skszaal/DBT2024/README.md

# DBT2024
This is the repository for the 2024 DBT project completed for MECE  2304
In this repostiory there is the arduino code, drawings/images of the project, and our final report.
