skszaal/DBT2024/Images_TechnicalDrawings/Caster wheel Drawing v1.pdf

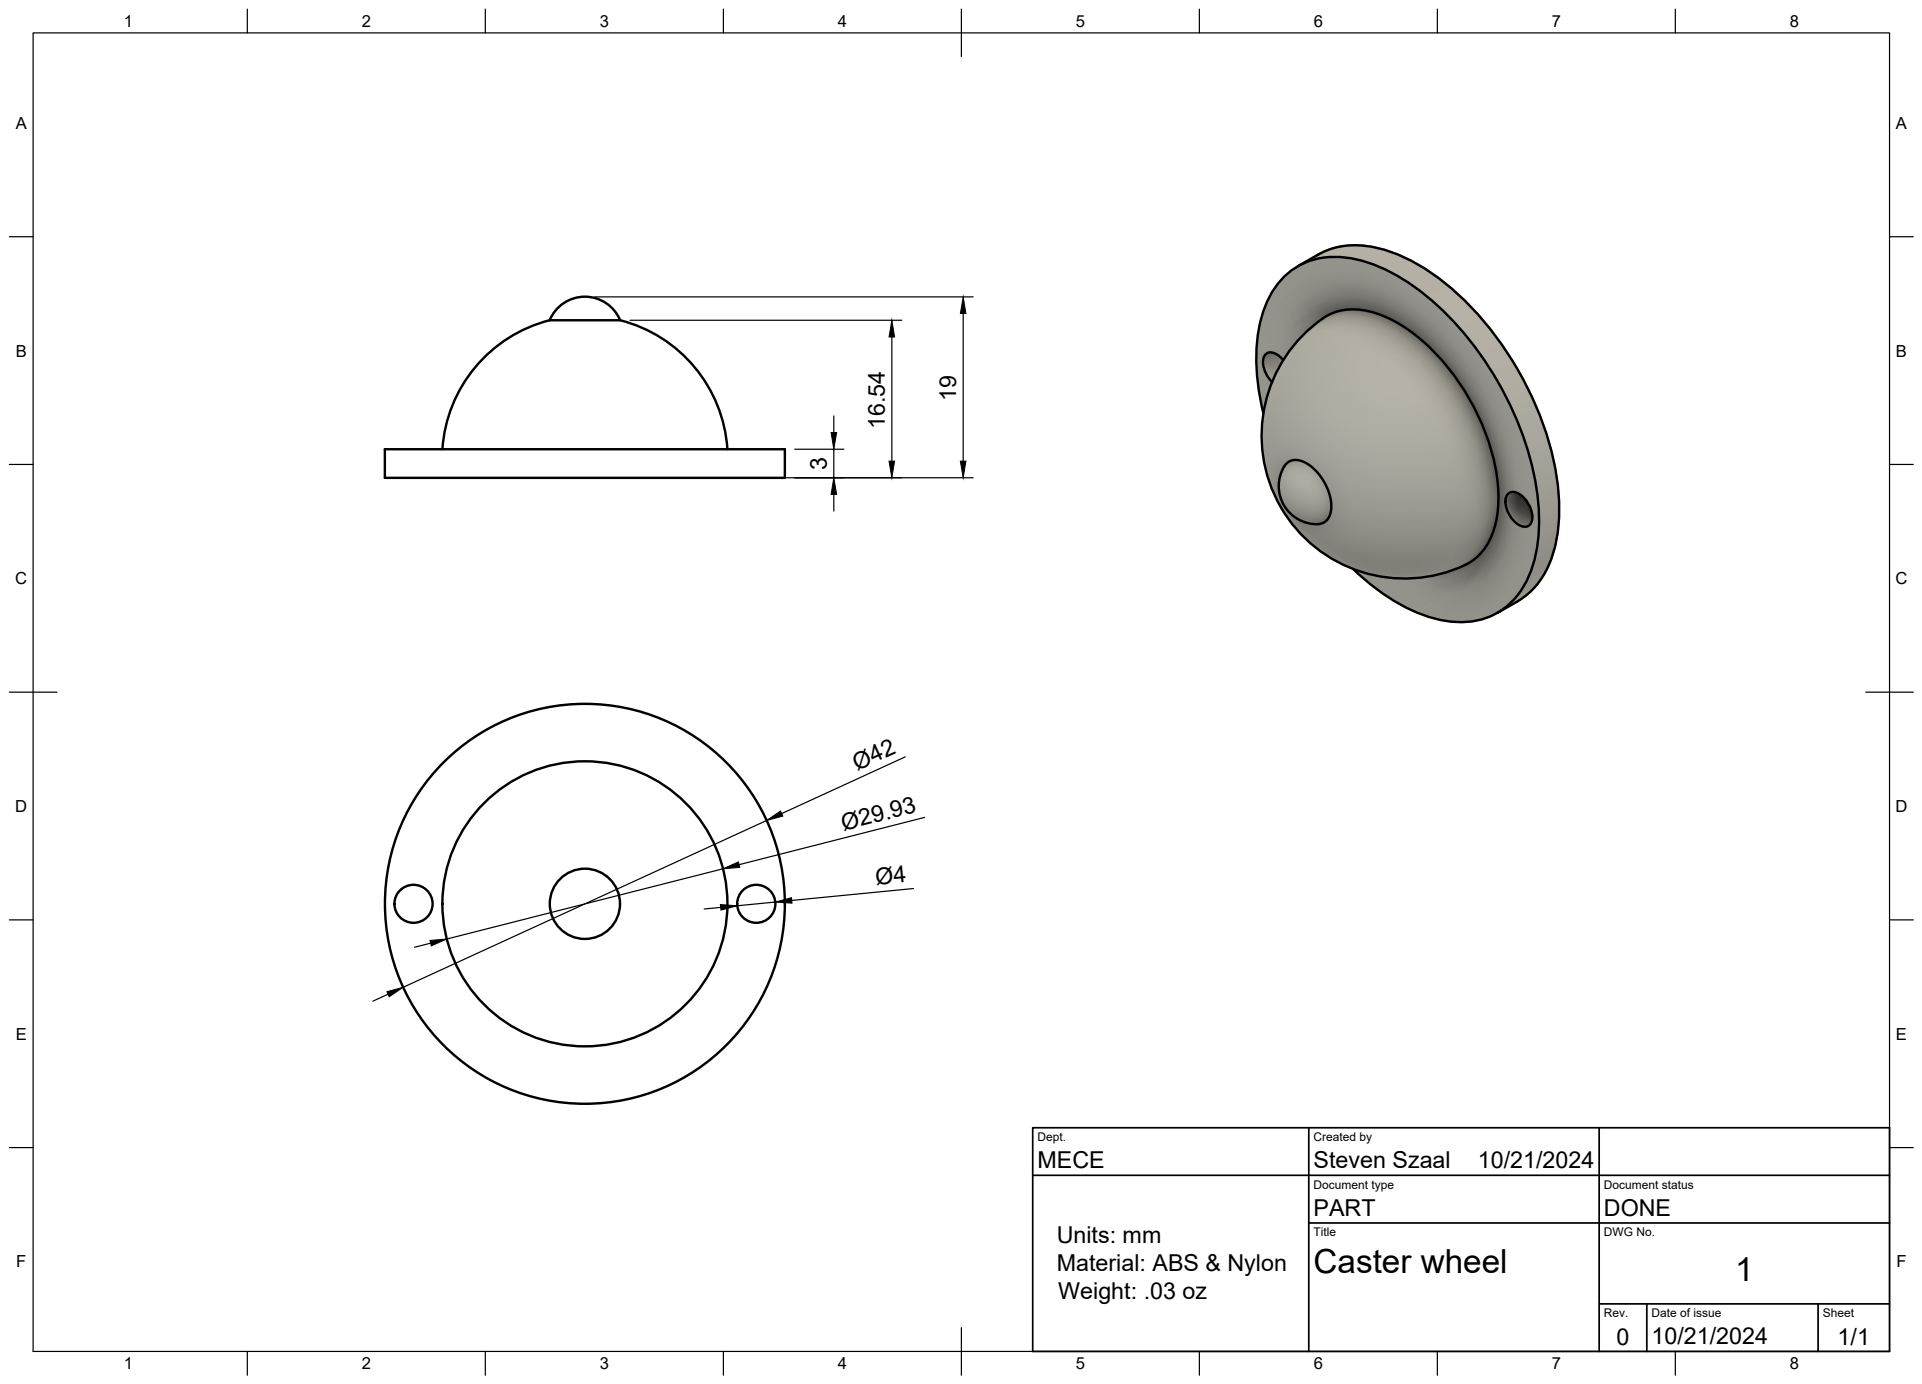
[picture p7: page 1]
Weight: .03 oz 19; Title; DWG No.; Rev.; Date of issue; Sheet; Caster wheel

Dept. MECE | Created by Steven Szaal 10/21/2024

Document type PART | Document status DONE

Units: mm
Material: ABS & Nylon
