skszaal/DBT2024/Images_TechnicalDrawings/Claw Arms.pdf

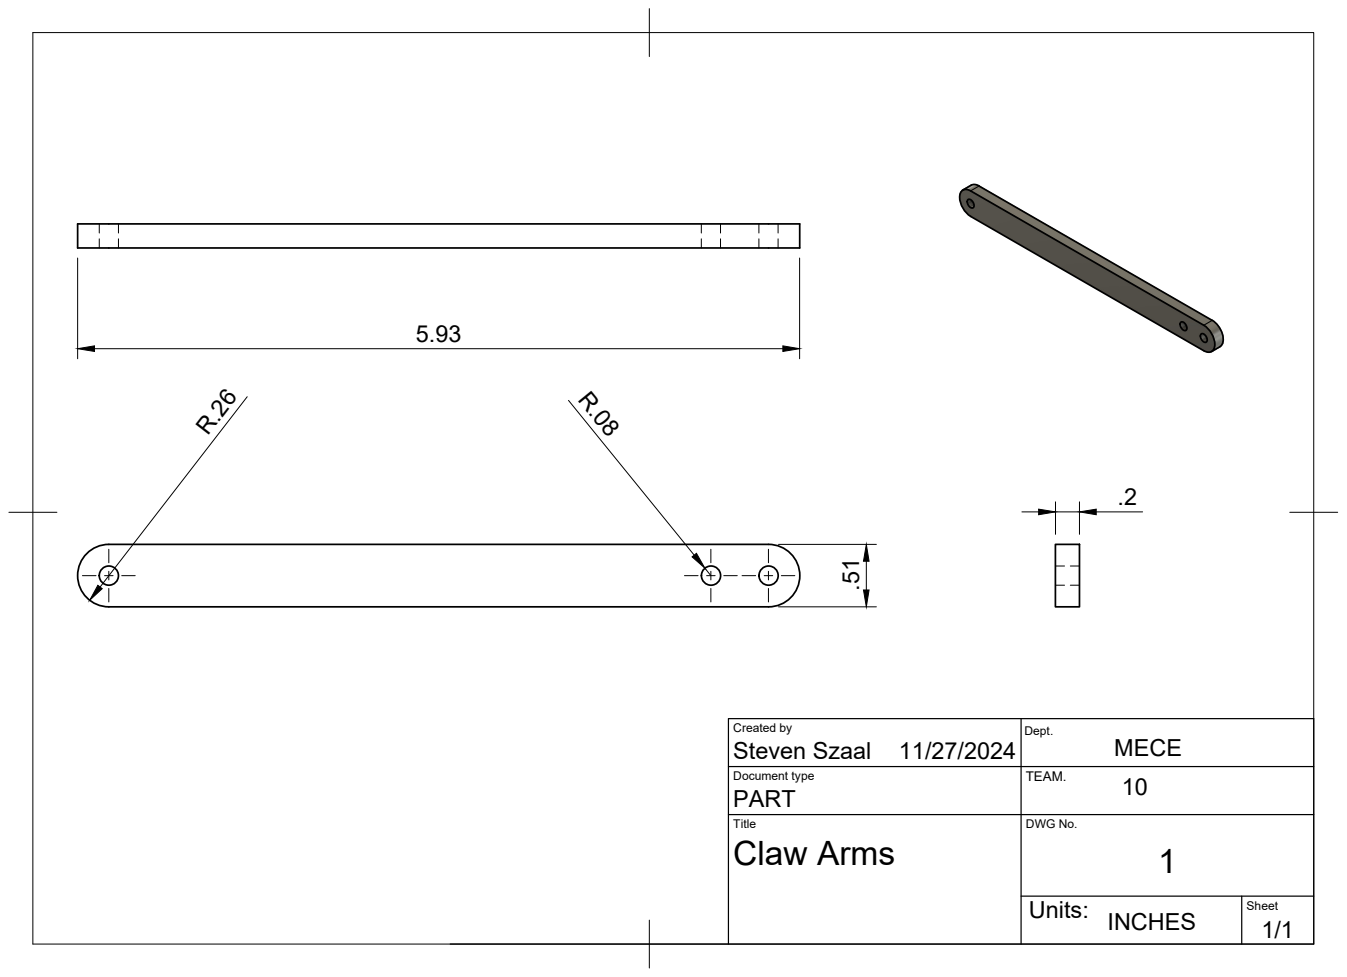
[picture p8: page 1]
Title; DWG No.; Claw Arms; INCHES .51

Created by Steven Szaal 11/27/2024 | Dept. MECE

Document type PART | TEAM. 10
