skszaal/DBT2024/Images_TechnicalDrawings/Motor brakets Drawing.pdf

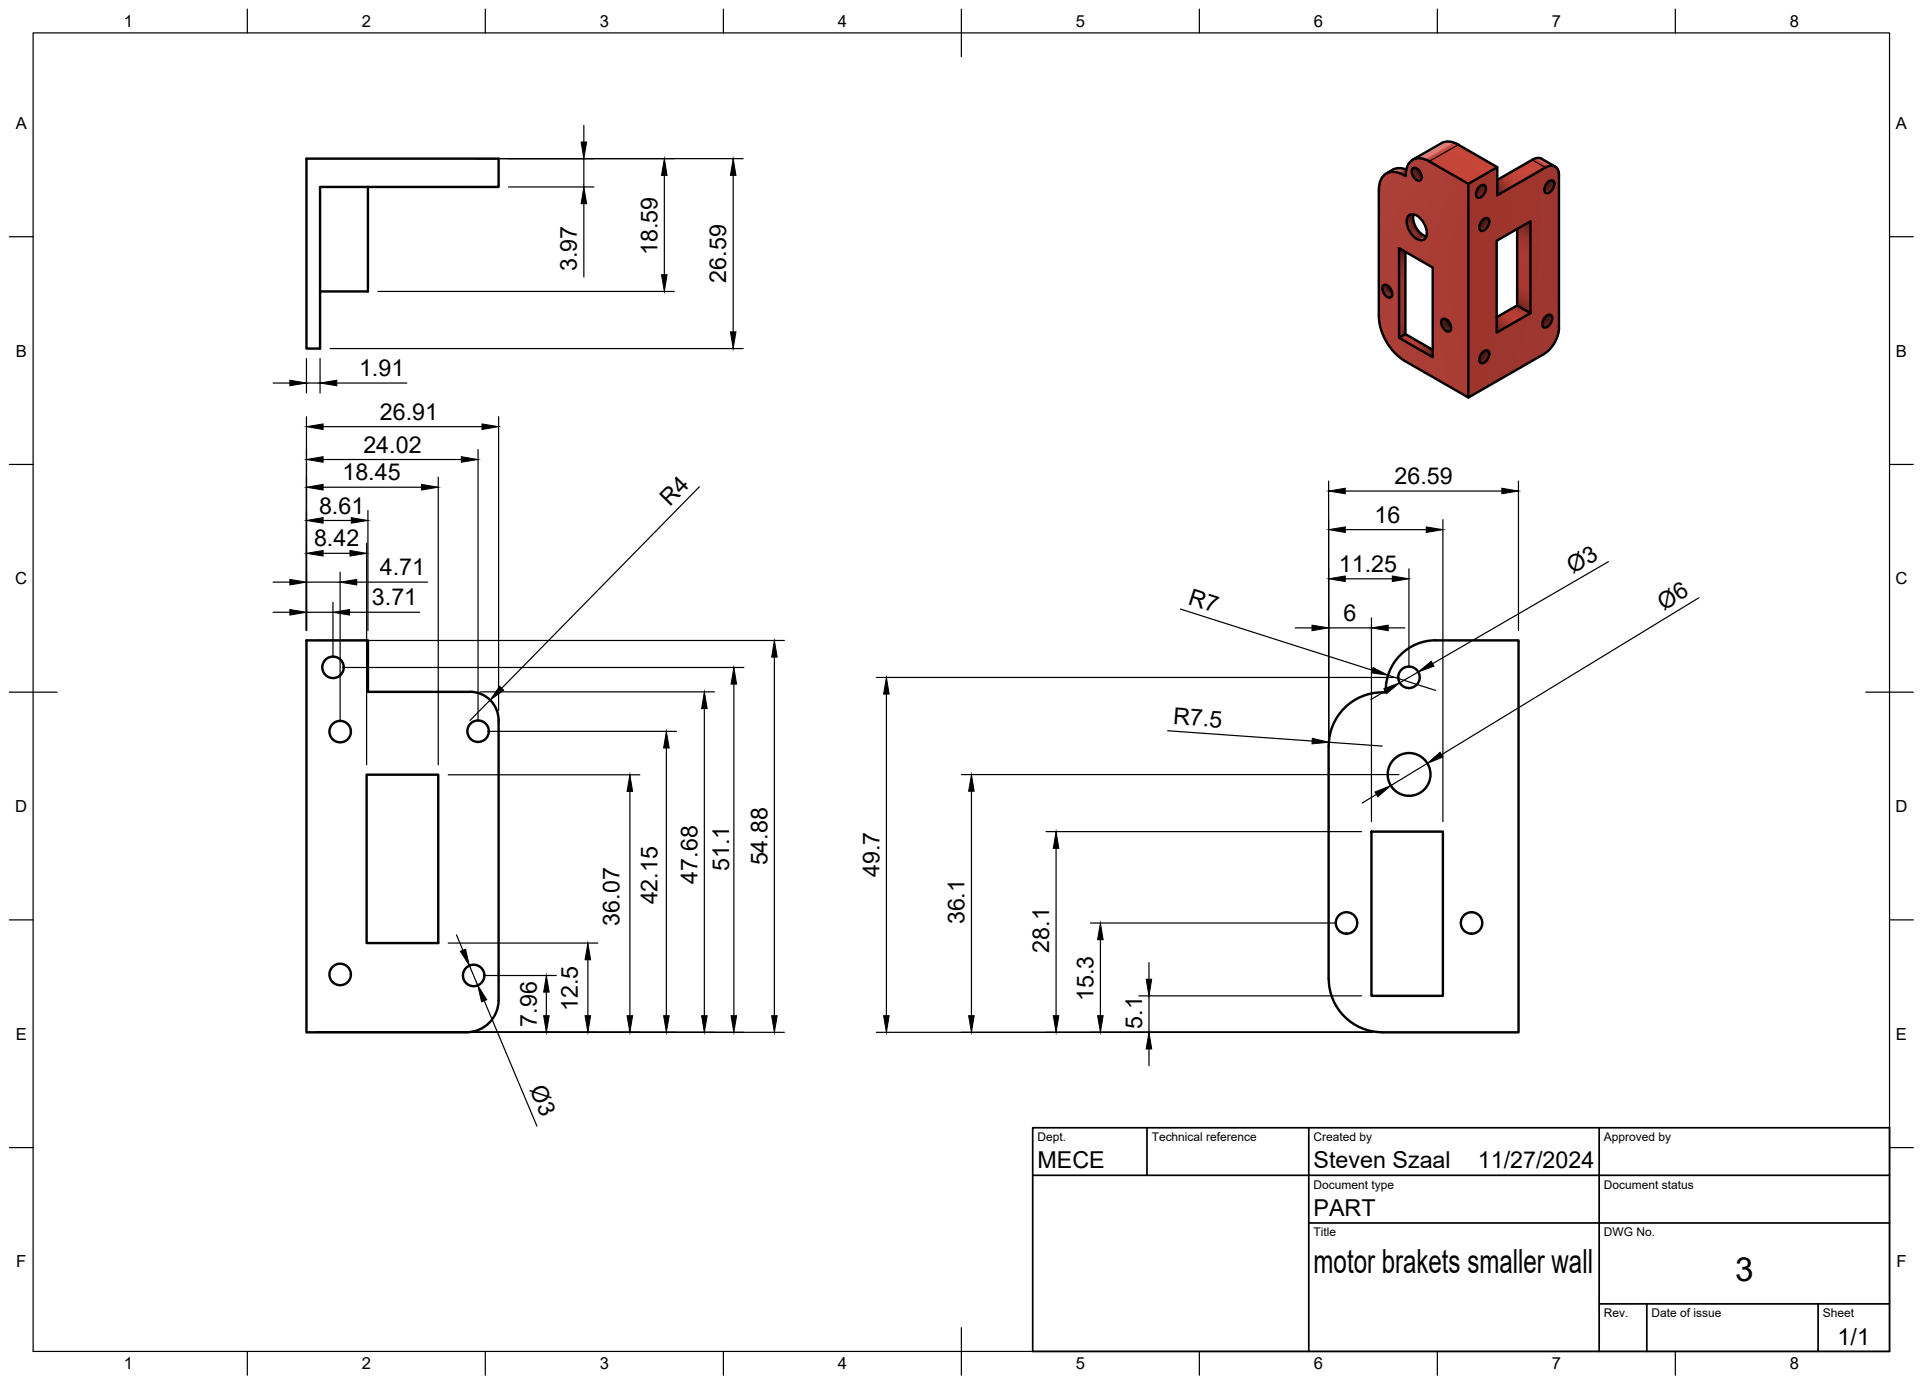
[picture p9: page 1]
8 BCDEF; ABCDEF; Title; DWG No.; Rev.; Date of issue; Sheet; motor brakets smaller wall; MECE; Steven Szaal 54.88 47.68 12.5

Dept. | Technical reference | Created by 11/27/2024 | Approved by

Document type PART | Document status
