skszaal/DBT2024/Images_TechnicalDrawings/Steppertowerweight Drawing v0.pdf

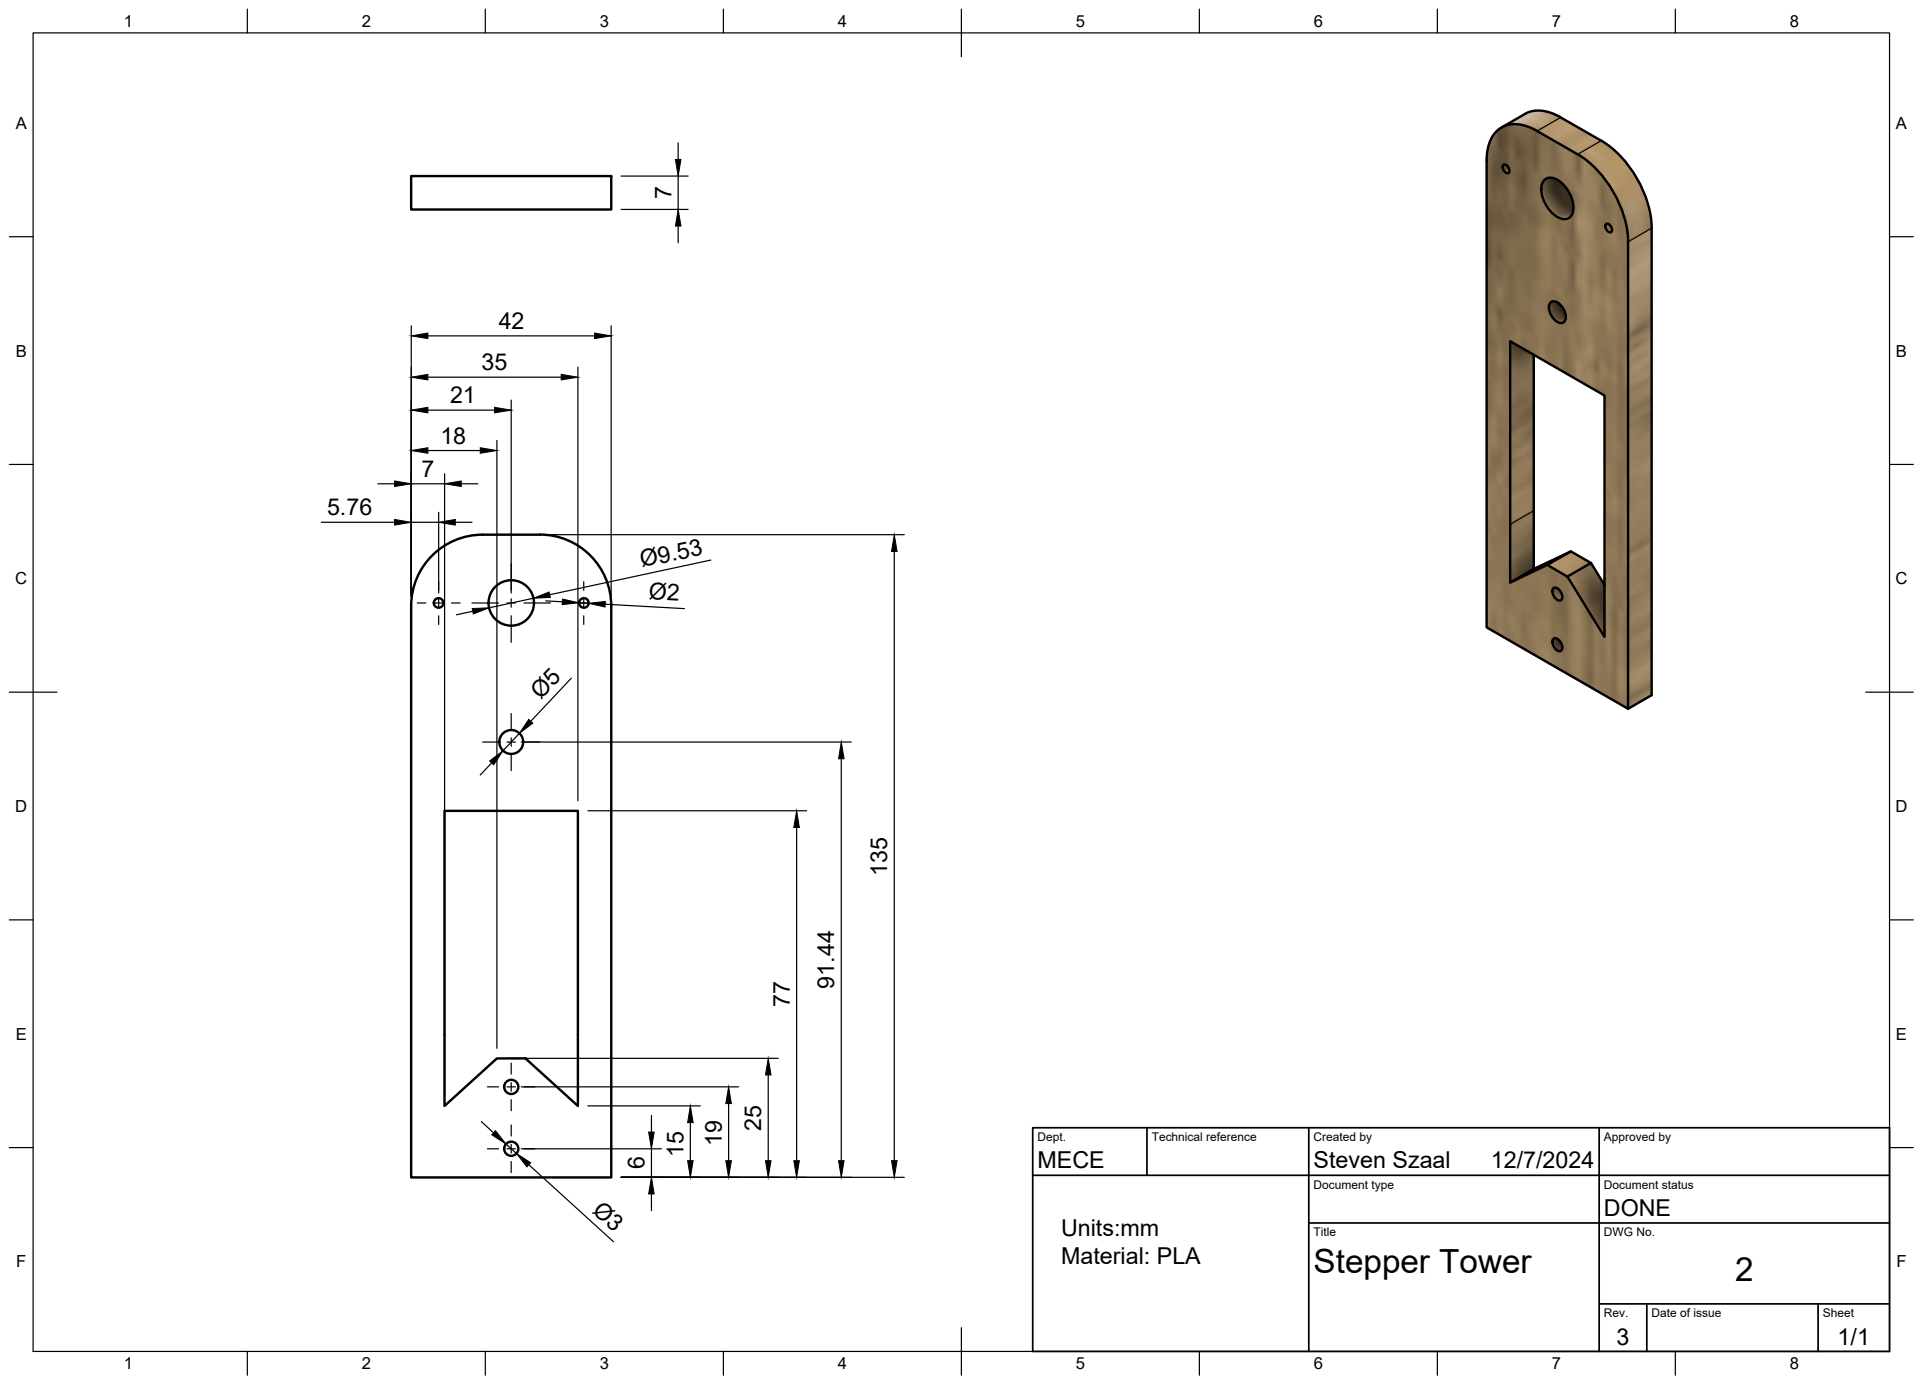
[picture p10: page 1]
Title; DWG No.; Rev.; Date of issue; Sheet; Stepper Tower; MECE; Steven Szaal 135; Material: PLA

Dept. | Technical reference | Created by 12/7/2024 | Approved by

Document type | Document status DONE
