skszaal/DBT2024/Images_TechnicalDrawings/Tower bracket Drawing v1.pdf

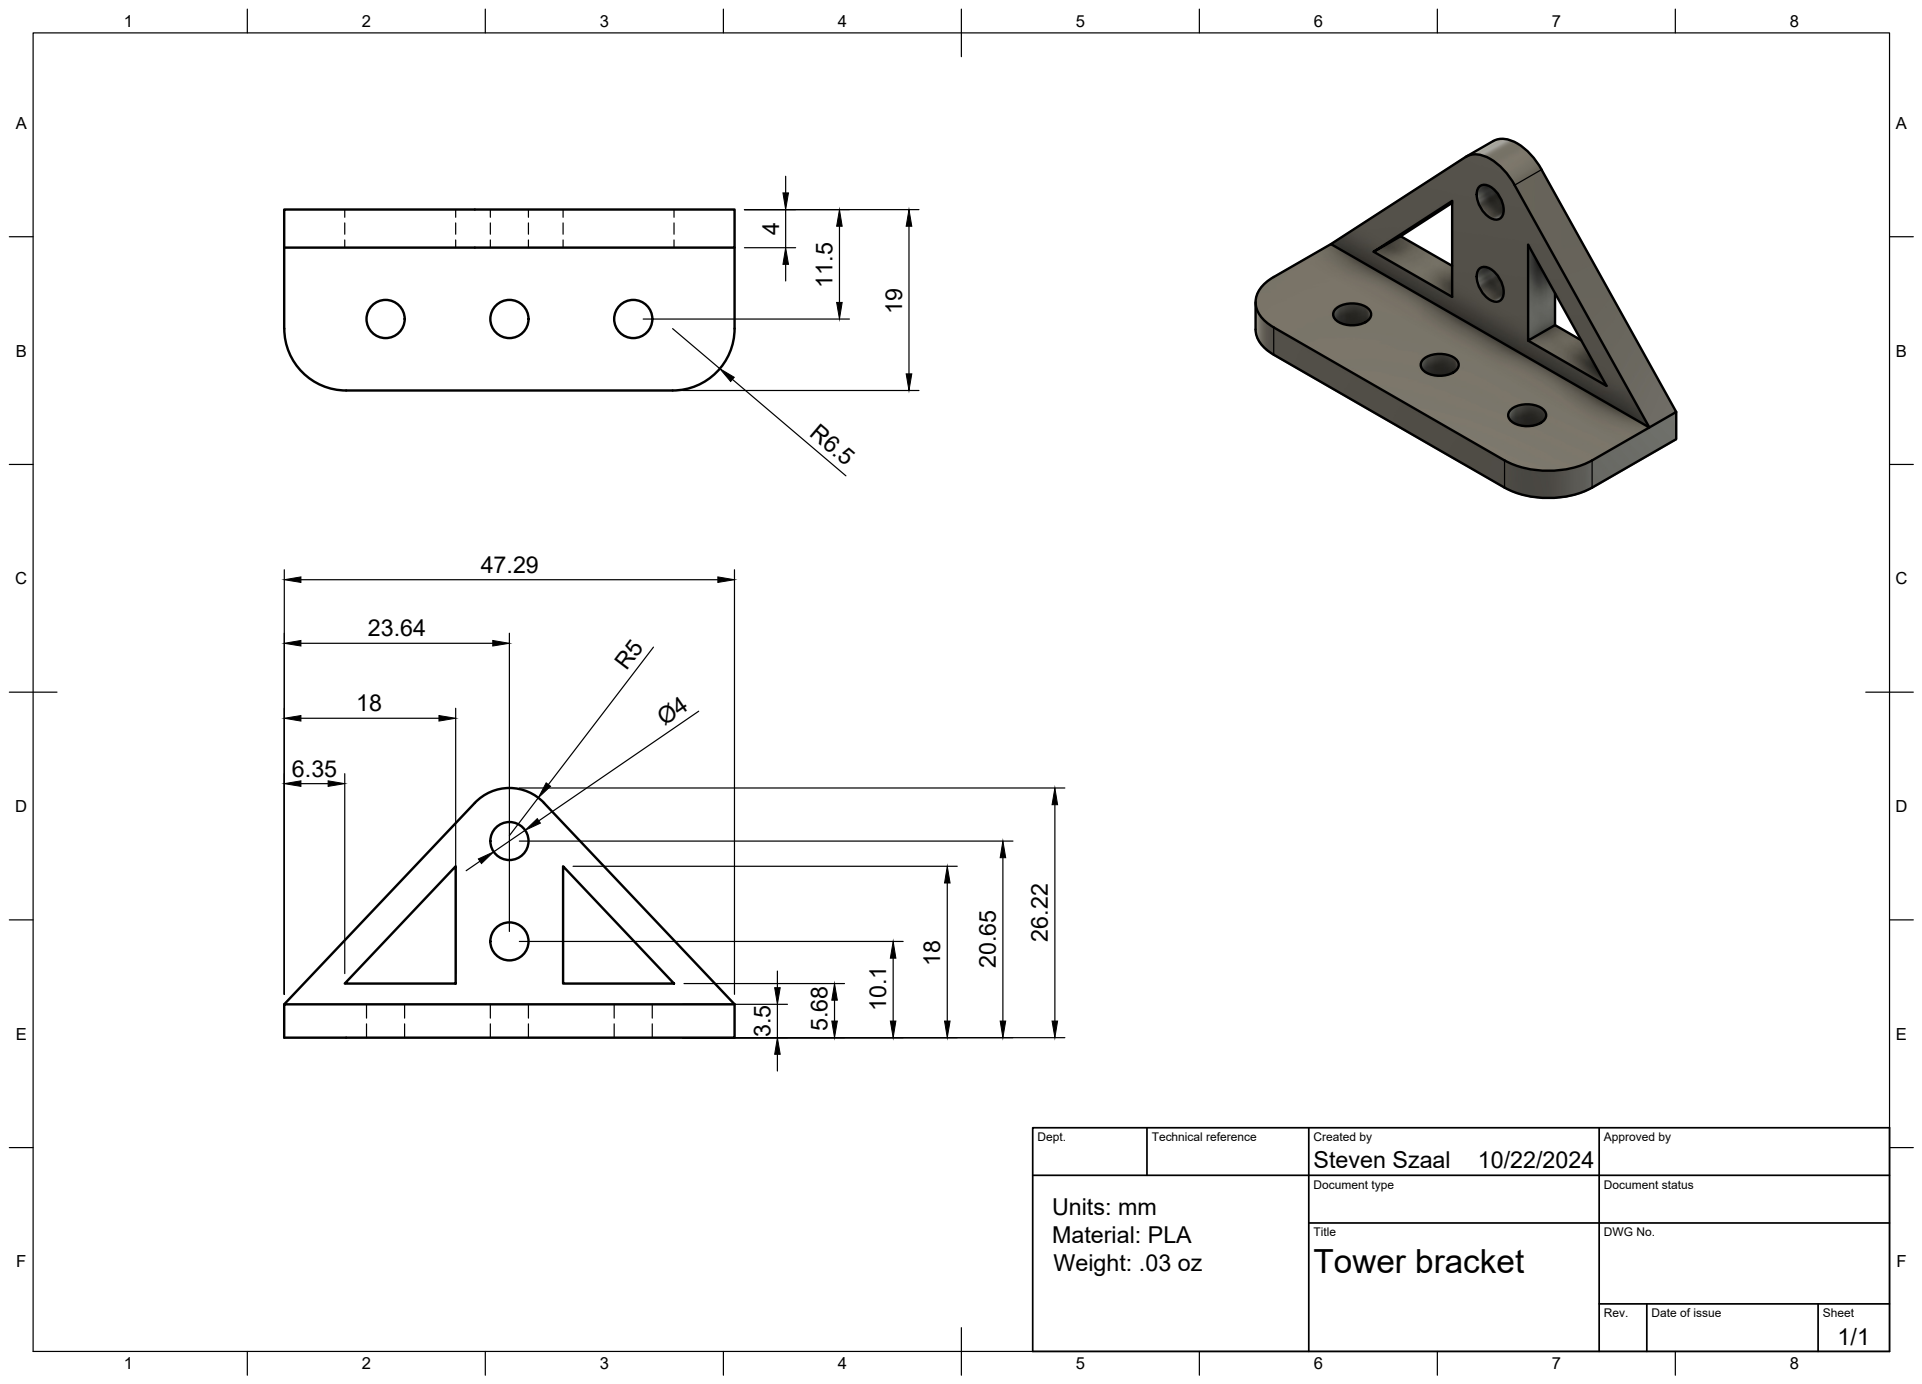
[picture p11: page 1]
Title; DWG No.; Rev.; Date of issue; Sheet; Tower bracket; Units: mm Material: PLA Weight: .03 oz

Dept. | Technical reference | Created by Steven Szaal 10/22/2024 | Approved by

Document type | Document status
