skszaal/DBT2024/(commit log)

2024-12-04 Code used for device
    Here is the code developed for our DBT device. It uses the Arduino IDE. The microcontroller used was the Adafruit feather M0 basic with feather wing stack.
2024-12-04 Images from the project
    These files contain an assembly drawing and a labeled device image.
2024-12-07 Rename Screenshot 2024-11-27 011154.png to Images_TechnicalDrawings/Build Assembly
